DreamOneX/sleep-environment-monitor/docs/00-project/02-handoff.md

# Handoff

Last updated: 2026-05-26.

When future work changes task status, records a new acceptance result, or finds
a new risk, update [03-todo.md](03-todo.md) in the same documentation pass.

## Current State

Phase 24 is complete in the current working tree. Phase 24Z, the BLE+Wi-Fi
coexistence heap fix, live Wi-Fi/BLE ACK suppression validation, the
2026-05-26 LED/existing-peer auth validation evidence, the final LED3
post-boot/download-mode acceptance, and the Phase 24 phone/gateway
interoperability scope decision are implemented or documented.

Phase 24P added live BLE evidence for two storage-transfer checks and the
current LED status boundary:

- Post-ACK oldest-record advancement succeeded with `scan-ack-then-peek-next`:
  ACKed sequence `108009`, then observed next oldest sequence `108010`.
- Disconnect before `CompleteRecord` or `AckRecord` preserved the oldest record
  after a drain precondition: first and second metadata reads both reported
  sequence `109130`, payload length `199`.
- LED facts are corrected: LED1 is green power on the 3.3 V rail and is not
  MCU-controlled; LED2 is red active-low on IO0; LED3 is blue active-low on IO1.
- Firmware keeps LED2 as heartbeat with a short boot/reset fast-flash and uses
  LED3 as normal status plus time-bounded BLE status overlay.

Phase 24Q added a compile-validated BLE security and authorization-record
persistence path. Phase 24R then validated the first Windows saved-bond restore
path on hardware and added a runtime saved-auth clear gesture:

- `firmware/src/storage/ble_auth.rs` now models fixed-size BLE auth records
  with identity address, LTK, optional IRK, security level, bonded flag, record
  CRC, record-set checksum, version policy, load/store/clear helpers, and pure
  tests.
- `firmware/src/tasks/ble.rs` seeds TrouBLE security from TRNG, restores saved
  bond records before host build, proactively requests security only while the
  BOOT / IO9 pairing window is open, requires encrypted matching saved auth
  outside the BOOT / IO9 window, and stores a bond record on
  `PairingComplete`.
- `tools/ble-watch` now includes `scan-read-metadata-now`, Windows Custom
  ConfirmOnly pairing, Windows pairing-state logging, `no-pair` mode,
  `scan-unpair`, and `scan-watch-clear-gesture`.
- Runtime BOOT / IO9 handling keeps the 2 second authorization-window gesture
  and adds an 8 second saved-auth clear gesture that erases
  `0x003bf000..0x003c0000` and reopens the temporary window.
- Hardware validation confirmed Windows pairing, BLE auth-sector write after
  `PairingComplete`, reboot restore of one saved authorization record, and
  encrypted metadata access with `scan-read-metadata-now ... expect-success
  no-pair`.

Phase 24S separated plain Wi-Fi/IP-not-ready indication from explicit network
faults in the blue LED3 policy:

- `config::led::WIFI_UNREADY_STATUS_WINDOW_SECS` defaults to `0`, disabling
  the plain Wi-Fi-unready slow-blink hint.
- Explicit `ErrorFlags::WIFI`, `ErrorFlags::IP`, and
  `ErrorFlags::DISCOVERY` still slow-blink LED3 through
  `ErrorFlags::NETWORK_MASK`.
- `ErrorFlags::NETWORK_MASK` remains scoped to the Wi-Fi/IP/discovery REST
  upload path and does not include BLE advertising, BLE connection, or BLE
  authorization state.
- BLE LED wording is aligned to the implemented runtime states:
  pairing/authorization fast blink and advertising-or-connected slow blink.

Phase 24T hardware-validated the BLE auth metadata reset policy:

- The existing BLE auth metadata sector was backed up from
  `0x003bf000..0x003c0000` to `/tmp/ble-auth-before-phase24t.bin`.
- Only `0x003bf000..0x003c0000` was deliberately written or erased with
  `cargo espflash write-bin` and `cargo espflash erase-region`.
- Missing/erased metadata, bad header magic, empty current-version records,
  records-version mismatch, compatibility-checksum mismatch, and header
  checksum mismatch all auto-opened the temporary authorization window on boot.
- After the final reset window closed, `scan-read-metadata-now ... expect-reject
  no-pair` confirmed an unpaired central was rejected at protected metadata
  control write.
- This did not validate the runtime 8 second BOOT / IO9 clear gesture itself.

Phase 24U hardened the Windows central validation tool after stale WinRT/GATT
objects blocked more hardware validation:

- GATT service and characteristic lookup now retry Uncached lookup and then use
  Cached lookup as a Windows stale-cache recovery fallback.
- Status reads retry but still use only Uncached status values for runtime
  decisions.
- `scan-read-status` can recreate the Windows `BluetoothLEDevice` / GATT
  objects after repeated status-read failures.
- `scan-watch-clear-gesture` can reconnect after a transient status-read
  failure instead of immediately ending the delay-safe watch.
- `scan-unpair` cleared the Windows-side pairing/cache state during recovery.

Phase 24V hardware-validated the runtime saved-auth clear effect:

- After Phase 24T left the board with invalid auth metadata and Windows unpaired,
  a non-flashing `probe-rs reset --chip esp32c3` reopened the temporary
  authorization window and restored BOOT / IO9 diagnostics to
  `boot_button=Released pressed_ms=0`.
- `scan-read-metadata-now 30 sleep-env-esp32c3 expect-success auto-pair`
  rebuilt one Windows saved-bond auth record. This may write only the BLE auth
  metadata sector `0x003bf000..0x003c0000`.
- `scan-read-metadata-now 30 sleep-env-esp32c3 expect-success no-pair` then
  confirmed protected metadata access through the saved authorization record.
- `scan-watch-clear-gesture 30 sleep-env-esp32c3 180 8000` observed
  `CLEAR_GESTURE_PRESSED_AFTER_RELEASE`,
  `CLEAR_GESTURE_HOLD_THRESHOLD pressed_ms=8000`, and
  `CLEAR_GESTURE_WINDOW_REFRESHED remaining_ms=60000`.
- The watch did not produce final `CLEAR_GESTURE_RESULT success=True` because
  firmware status frames continued to report `boot_button=Pressed` after the
  operator released IO9. The operator did not hold IO9 for 40 seconds or
  longer; treat this as an IO9 release-diagnostics mismatch.
- `scan-read-metadata-now 30 sleep-env-esp32c3 expect-reject no-pair` reported
  `METADATA_NOW_RESULT success=True metadata_success=False rejected=True
  phase=control_write`, proving the previous saved authorization no longer
  grants protected metadata access.
- After a non-flashing `probe-rs reset --chip esp32c3`, `scan-unpair` reported
  `UNPAIR_RESULT status=Unpaired`, and a final status read decoded
  `pairing=Open boot_button=Released remaining_ms=39050 pressed_ms=0`.

Phase 24W improved `tools/ble-watch` release diagnostics for the next runtime
clear retest:

- `scan-watch-clear-gesture` still requires release before press,
  press-after-release, 8 second hold threshold, refreshed authorization window,
  and release after hold before returning success.
- The tool now prints `CLEAR_GESTURE_CLEAR_EFFECT_OBSERVED` after hold
  threshold plus refreshed-window evidence.
- If the watch ends after that clear-effect evidence but before final release
  observation, it prints `CLEAR_GESTURE_RELEASE_DIAGNOSTIC_MISSING` with event
  indexes, hold milliseconds, refreshed-window remaining milliseconds, and
  latest status fields.
- The new diagnostic output does not change firmware behavior and does not
  accept the BOOT / IO9 release item by itself.

Phase 24X added pure BLE auth-record upsert policy coverage and reused it from
the target persistence path:

- `storage::ble_auth::upsert_auth_record` updates an existing record by
  identity address or matching IRK, appends while capacity remains, replaces
  index `0` when full, clamps overlarge stored record counts, and reports
  `NoCapacity` for empty storage.
- `firmware/src/tasks/ble.rs` now calls that pure policy when persisting a
  `PairingComplete` bond record.
- This is compile and host-test coverage only. Real runtime auth-record
  replacement/update still needs hardware validation with another bond or an
  existing peer update.

Phase 24Y added firmware-side BOOT / IO9 transition logging for the next
release-diagnostics retest:

- The BLE pairing task logs the initial BOOT / IO9 runtime sample.
- It logs each sampled transition between `Pressed` and `Released`.
- Each log includes accumulated press milliseconds and pairing-window remaining
  milliseconds.
- This does not change pairing-window or saved-auth clear behavior and does not
  accept the release-diagnostics item without a new hardware run.

A 2026-05-25 hardware review corrected the BOOT / IO9 electrical assumptions:

- The board has no discrete IO9 pull-up resistor.
- ESP32-C3 boot/strap sampling provides a weak IO9 pull-up during boot, but
  runtime firmware must not assume that pull-up remains configured.
- The BOOT button pulls IO9 to GND and has an IO9-to-GND capacitor in parallel.
- BLE feature builds now configure GPIO9 as input-only with the MCU internal
  pull-up explicitly enabled at runtime.
- The IO9-to-GND capacitor and previous no-pull runtime configuration may
  explain the earlier `Pressed`-after-release status observation. Retest
  release diagnostics with the explicit runtime pull-up firmware before drawing
  conclusions about BLE status/tooling.

Phase 24Z retested BOOT / IO9 with the explicit runtime GPIO9 pull-up firmware:

- The BLE+Wi-Fi app image was flashed after declaring the app-image range as
  approximately `0x00010000..0x003bf000`.
- The runtime clear gesture deliberately erased the BLE auth metadata sector
  `0x003bf000..0x003c0000`.
- `scan-watch-clear-gesture 30 sleep-env-esp32c3 180 8000` observed release
  before press, press-after-release, `CLEAR_GESTURE_HOLD_THRESHOLD
  pressed_ms=8100`, refreshed authorization window `remaining_ms=59900`, final
  release after hold, and `CLEAR_GESTURE_RESULT success=True`.
- Firmware RTT logs matched the central output with
  `ble boot/io9 transition state=Pressed`, `ble auth records clear requested
  pressed_ms=8000`, `ble auth records cleared offset=0x003bf000 len=4096`, and
  `ble boot/io9 transition state=Released`.
- After the refreshed authorization window expired,
  `scan-read-metadata-now 30 sleep-env-esp32c3 expect-reject no-pair` reported
  `METADATA_NOW_RESULT success=True metadata_success=False rejected=True
  phase=control_write`.
- The BOOT / IO9 runtime clear/release diagnostic item is now hardware
  accepted for the explicit runtime pull-up firmware.
- The same BLE+Wi-Fi runtime reported `Wi-Fi controller initialization failed;
  network and uploader disabled` with ESP Wi-Fi init error `257`; this is now
  a remaining Wi-Fi/BLE runtime coexistence issue to resolve or explicitly
  accept before Phase 24 closes.

The follow-up BLE+Wi-Fi coexistence heap fix resolves the Phase 24Z Wi-Fi
controller initialization failure as a startup blocker:

- BLE+Wi-Fi feature builds now add a second internal heap region of 64 KiB in
  addition to the reclaimed heap. This follows the `esp-generate` Wi-Fi+BLE
  template pattern that notes coexistence needs more RAM.
- The Wi-Fi initialization failure log now preserves the concrete `WifiError`
  enum for future diagnosis.
- A hardware `cargo run --target riscv32imc-unknown-none-elf --features
  ble-upload,radio-coex` flashed the app image after declaring the app-image
  range as approximately `0x00010000..0x003bf000`.
- RTT logs showed `wifi connecting`, `wifi connected`, IPv4 configuration,
  BLE advertising, and BLE central connect/disconnect events. The previous
  `Wi-Fi controller initialization failed ... error=257` log did not appear.
- `ble-watch scan-read-status 30 sleep-env-esp32c3` succeeded and decoded
  `runtime=Connected network=IpReady upload=TimeFailed pending=32`, proving
  the BLE GATT status path and IP-ready Wi-Fi status were present in the same
  BLE+Wi-Fi runtime.
The subsequent live Wi-Fi/BLE ACK suppression run accepts the Phase 24
coexistence ACK-policy item for the observed hardware case:

- The formal server accepted repeated REST uploads from the board with HTTP
  `204`; firmware logs showed discovery, time sync, and `upload success`.
- `scan-transfer-record-now 30 sleep-env-esp32c3 ack 128 auto-pair` transferred
  sequence `136853` without waiting for a BOOT / IO9 authorization window.
- Initial and final BLE status snapshots decoded
  `runtime=Connected network=IpReady upload=Success pending=0`.
- The Windows central requested `AckRecord`, but firmware logged
  `ble storage ACK suppressed sequence=136853 network_state=IpReady
  upload_result=Success`.
- This proves the live BLE ACK path does not delete storage while Wi-Fi/IP is
  ready and REST upload is succeeding.

The 2026-05-26 hardware session accepted the existing Windows-central
auth-record update path and two LED3 BLE visual states:

- `scan-unpair-then-pair-metadata` opened the authorization window but timed
  out near the manual timing boundary. A following
  `scan-read-metadata-now 30 sleep-env-esp32c3 expect-success auto-pair`
  completed pairing and read protected metadata.
- Firmware RTT logs showed `ble auth record updated index=0` and
  `ble auth bond stored count=1 offset=0x003bf000 len=4096`, accepting the
  existing-peer runtime update path.
- While `scan-watch-status` held a BLE connection with `pairing=Closed`, the
  operator reported `LED3 慢闪`, accepting the advertising-or-connected slow
  blink for the exercised state.
- During a BOOT / IO9-triggered `pairing=Open` window, the operator reported
  `LED3 快闪`, accepting the pairing/authorization fast blink for the exercised
  state and the BOOT-triggered overlay case where the pairing window remains
  open longer than 10 seconds.
- That manual fast-blink hold also crossed the 8 second clear threshold again.
  Firmware logged `ble auth records clear requested pressed_ms=8000` and
  `ble auth records cleared offset=0x003bf000 len=4096`, so the BLE auth
  metadata sector was exercised during this session.
- A following hard reset restored the application BLE path. After clearing
  stale Windows-side pairing state with `scan-unpair`, `scan-read-status`
  decoded `runtime=Connected network=IpReady upload=TransportFailed
  pending=32` and `pairing=Closed boot_button=Released`.
- Read-only BOOT/download-mode probes were inconclusive: `cargo espflash
  board-info` attempts using `--before no-reset --after no-reset`, `--before
  usb-reset --after no-reset`, and `--before default-reset --after hard-reset`
  all failed with `Error while connecting to device`. Do not count that as
  download-mode preservation evidence. After the failed probes, BLE status
  reads still confirmed the application path can recover:
  `runtime=Connected network=IpReady upload=TransportFailed pending=32` and
  `pairing=Closed boot_button=Released`.

The final Phase 24 acceptance pass closed the remaining Phase 24 hardware and
scope items:

- `tools/ble-watch scan-watch-status` now reopens the Windows GATT status
  connection if a long status watch hits a recoverable stale WinRT/GATT object.
  The Windows .NET build passed with 0 warnings and 0 errors.
- After `probe-rs reset --chip esp32c3`, `scan-watch-status 30
  sleep-env-esp32c3 180` started a machine-side status trace and decoded
  `runtime=Connected network=IpReady`, `pairing=Open`, and
  `boot_button=Released` early in the post-boot window. The operator manually
  accepted the blue LED3 180 second post-boot BLE status window.
- BOOT / IO9 download-mode preservation during reset or power-on was accepted
  by operator-assisted validation. This validates that holding BOOT / IO9 at
  reset or power-on still selects ESP32-C3 download mode rather than runtime
  BLE pairing or BLE auth-record clearing.
- Phone/gateway interoperability beyond the Windows `ble-watch` central is
  `skipped / not planned` for Phase 24. This repository does not implement a
  mobile app or gateway in Phase 24; Windows `ble-watch` remains the accepted
  Phase 24 validation central. Future phone/gateway behavior should start from
  a separate app/gateway plan if that product direction is revived.
- A final `scan-read-status 30 sleep-env-esp32c3` confirmed the application BLE
  path recovered after the acceptance steps:
  `runtime=Connected network=IpReady upload=TimeFailed pending=32` and
  `pairing=Closed boot_button=Released`.

Firmware was flashed during Phase 24R hardware validation with the BLE+Wi-Fi
build using `probe-rs` through the ESP JTAG interface. Before flashing, the
declared ranges were:

Important flash ranges:

- App firmware region: approximately `0x00010000..0x003bf000`.
- BLE auth metadata sector: `0x003bf000..0x003c0000`. Phase 24R deliberately
  exercised a write to this sector through `PairingComplete` and restored one
  saved record after reboot. Phase 24T deliberately erased or overwrote this
  same sector to validate reset/invalid metadata auto-pair behavior. Phase 24V
  validated the runtime clear effect through hold-threshold/window-refresh
  evidence and rejected protected metadata access after the clear watch.
  Phase 24Z validated final BOOT / IO9 release-after-hold diagnostics and again
  cleared this sector through the runtime gesture. The 2026-05-26
  existing-peer update wrote this sector through bond storage, and the later
  LED3 fast-blink check erased it again through the runtime clear gesture.
- Measurement spool: `0x003c0000..0x00400000`. BLE ACK/drain validation may
  exercise normal spool writes/erases through `storage_task` in this range.
  During the long Phase 24R runtime, the storage task continued appending and
  dropping oldest records as the spool filled.

Before any future flash-write validation, state the exact range being
exercised.

## Implemented

- `tools/ble-watch` includes `scan-drain-then-disconnect-preserves-record`.
- `tools/ble-watch` retries Windows GATT service and characteristic lookup,
  retries Uncached status reads, recreates status connections for
  `scan-read-status`, reconnects the runtime clear-gesture watch after a
  transient status-read failure, and reconnects `scan-watch-status` after a
  recoverable stale WinRT/GATT status-read failure. It also distinguishes
  clear-effect evidence from missing final release observation in
  `scan-watch-clear-gesture`.
- `firmware/src/board.rs` maps MCU-controlled LEDs as `PIN_LED2 = 0` and
  `PIN_LED3 = 1`.
- `firmware/src/tasks/led.rs` fast-flashes red LED2 at boot/reset and then runs
  the heartbeat.
- `firmware/src/util/status.rs` exposes pure LED status mapping for the blue
  LED3 BLE overlay, including pairing fast blink, BLE runtime slow blink, and
  boot/trigger indication windows.
- `firmware/src/tasks/led.rs` uses
  `config::led::WIFI_UNREADY_STATUS_WINDOW_SECS` to decide whether plain
  Wi-Fi/IP-not-ready state should temporarily slow-blink LED3. The default `0`
  keeps that hint disabled, while explicit network error flags still slow-blink.
- `firmware/src/bin/main.rs` routes GPIO0 to the LED2 heartbeat task and GPIO1
  to the LED3 status task, and wires BLE runtime/pairing signals into LED3.
- `firmware/src/tasks/ble.rs` publishes BLE runtime and pairing status for the
  LED overlay, owns the BLE security compile path, and stores/loads BLE auth
  records through the reserved auth sector using the shared pure upsert policy.
  It also clears the saved auth sector on the 8 second runtime BOOT / IO9
  gesture and logs BOOT / IO9 initial/transition samples for release
  diagnostics. GPIO9 is configured input-only with the MCU internal pull-up
  explicitly enabled in BLE feature builds.
- `firmware/src/bin/main.rs` obtains a BLE security seed from TRNG before
  reusing ADC1 for the microphone path.
- `tools/ble-watch` includes `scan-transfer-record-now` for saved-bond or
  auto-pair transfer without waiting for the BOOT / IO9 authorization window.
- Documentation records Phase 24P storage-transfer evidence, Phase 24R
  saved-bond restore evidence, Phase 24S LED status/config boundary, Phase 24T
  auth metadata reset evidence, Phase 24U Windows GATT recovery tooling,
  Phase 24V runtime clear-effect evidence, Phase 24W clear-gesture diagnostic
  tooling, Phase 24X auth-record upsert policy coverage, Phase 24Y BOOT / IO9
  transition diagnostics, Phase 24Z runtime IO9 pull-up retest evidence, the
  BLE+Wi-Fi coexistence heap startup fix, live Wi-Fi/BLE ACK suppression
  evidence, existing-peer auth update evidence, current LED mapping, final
  LED3 visual acceptance, BOOT download-mode acceptance, and the Phase 24
  phone/gateway `skipped / not planned` scope decision.

The hardware-validated BLE authorization paths are now the temporary BOOT / IO9
window, the Windows saved-bond restore path, the auth metadata reset policy,
the Phase 24Z runtime clear/release path, and the existing Windows-central
auth-record update path. The latest board state has firmware auth metadata
cleared or missing after the 2026-05-26 LED3 fast-blink hold crossed the clear
threshold. Windows Settings may show the custom GATT peripheral as paired but
not connected when `ble-watch` is not holding a GATT session; that passive
Settings label is not a Phase 24 acceptance signal. If Windows still reports
paired while firmware rejects protected access after an auth reset or clear,
use `scan-unpair` before re-pairing. A distinct second-central append or
full-capacity auth replacement run remains useful future coverage, but the
existing-peer update item has hardware evidence.

Current board/test starting point:

- No new firmware image was flashed during the 2026-05-26 LED/existing-peer
  auth session.
- No `probe-rs`, `ble-watch`, `espflash`, or local server process should be
  assumed to still be running from that session.
- After the final acceptance pass, the application BLE path was reachable. The
  latest useful status evidence decoded
  `runtime=Connected network=IpReady upload=TimeFailed pending=32` and
  `pairing=Closed boot_button=Released`.
- The firmware auth metadata is likely cleared or missing because the last
  BOOT / IO9 fast-blink observation crossed the 8 second runtime clear
  threshold. Protected metadata, transfer, or saved-bond tests should expect to
  re-pair first, and stale Windows pairing should be removed with `scan-unpair`
  if firmware rejects access.
- The older `cargo espflash board-info` attempts are failed/inconclusive
  historical evidence, not the accepted download-mode validation. The final
  operator-assisted BOOT / IO9 reset or power-on check accepted download-mode
  preservation for Phase 24.

Manual hardware tests that need operator timing, such as BOOT / IO9 presses,
must first notify the operator through PowerShell
`New-BurntToastNotification`. Do not assume human cooperation is available
until the operator replies in chat that the notification was received and they
are ready. The same rule is recorded in local `environment.md`, which is
ignored by `.gitignore`.

## Subagents

Requested subagents completed or reported during this handoff:

- Documentation/fact check: no high-severity current fact conflicts were found.
  The important follow-up was to keep old "paired central" wording precise and
  keep old LED2 status wording marked as historical where relevant.
- Architecture file-tree/config update: directly updated
  `docs/10-firmware/00-architecture.md` with directory-first file tree and
  `config.rs` ownership details.
- Wi-Fi config check: default `FZU` open network remains a bring-up default and
  should not be treated as a deployment credential model; future work should
  avoid committing real passwords, mark WPA/mixed modes as legacy, and consider
  test/build-time validation for the default credential triple.
- Duplicate-code check: Phase 24 should avoid broad refactors; Phase 25 should
  keep `docs/10-firmware/05-ble.md` as the BLE ACK/security rule authority,
  keep LED overlay rules centralized, and split protocol/helper duplication
  only after behavior is frozen.
- `cfg(target_arch = "riscv32")` check: most cfgs are valid embedded/host-test
  boundaries; the real boundary debt is the large `tasks/ble.rs` module, which
  should be split in Phase 25 after behavior is frozen.
- Phase 25 refactor plan: split `tools/ble-watch`, `tasks/upload.rs`, and
  `tasks/ble.rs` by equivalent moves only. Freeze BLE UUIDs, status/metadata /
  control frame bytes, Wi-Fi HTTP 2xx ACK semantics, BLE ACK policy, flash
  ranges, and payload JSON shape.

## Verification

Phase 24T firmware and documentation verification passed:

```bash
cargo fmt
cargo test --lib
cargo build --target riscv32imc-unknown-none-elf
cargo build --target riscv32imc-unknown-none-elf --features ble-upload,radio-coex
cargo clippy --all-targets
cargo clippy --target riscv32imc-unknown-none-elf
cargo clippy --target riscv32imc-unknown-none-elf --features ble-upload,radio-coex
git diff --check
```

Observed result:

- `cargo test --lib`: `185 passed; 0 failed`.
- Normal ESP32-C3 target build: passed.
- BLE+Wi-Fi coexistence ESP32-C3 target build: passed.
- Host clippy, normal target clippy, and BLE+coex target clippy: passed.
- `git diff --check`: passed.

Milestone commit message:

```text
test: validate BLE auth metadata reset policy
```

Phase 24U tool verification:

```bash
'/mnt/c/Program Files/dotnet/dotnet.exe' build "$(wslpath -w tools/ble-watch/ble-watch.csproj)"
'/mnt/c/Program Files/dotnet/dotnet.exe' "$(wslpath -w tools/ble-watch/bin/Debug/net10.0-windows10.0.19041.0/ble-watch.dll)" scan-unpair 30 sleep-env-esp32c3
'/mnt/c/Program Files/dotnet/dotnet.exe' "$(wslpath -w tools/ble-watch/bin/Debug/net10.0-windows10.0.19041.0/ble-watch.dll)" scan-read-status 30 sleep-env-esp32c3
git diff --check
```

Observed result:

- The Windows .NET build passed with 0 warnings and 0 errors.
- `scan-unpair` reported `UNPAIR_RESULT status=Unpaired`.
- A following `scan-read-status` succeeded after stale GATT recovery and
  decoded `runtime=Connected network=Disconnected upload=Failed pending=32
  error_flags=0x00000000 pairing=Closed boot_button=Released remaining_ms=0
  pressed_ms=0`.
- No firmware image was flashed and no firmware flash sector was deliberately
  written or erased.

Milestone commit message:

```text
test: harden BLE watch GATT recovery
```

Phase 24V hardware verification:

```bash
probe-rs reset --chip esp32c3
'/mnt/c/Program Files/dotnet/dotnet.exe' "$(wslpath -w tools/ble-watch/bin/Debug/net10.0-windows10.0.19041.0/ble-watch.dll)" scan-read-status 30 sleep-env-esp32c3
'/mnt/c/Program Files/dotnet/dotnet.exe' "$(wslpath -w tools/ble-watch/bin/Debug/net10.0-windows10.0.19041.0/ble-watch.dll)" scan-read-metadata-now 30 sleep-env-esp32c3 expect-success auto-pair
'/mnt/c/Program Files/dotnet/dotnet.exe' "$(wslpath -w tools/ble-watch/bin/Debug/net10.0-windows10.0.19041.0/ble-watch.dll)" scan-read-metadata-now 30 sleep-env-esp32c3 expect-success no-pair
'/mnt/c/Program Files/dotnet/dotnet.exe' "$(wslpath -w tools/ble-watch/bin/Debug/net10.0-windows10.0.19041.0/ble-watch.dll)" scan-watch-clear-gesture 30 sleep-env-esp32c3 180 8000
'/mnt/c/Program Files/dotnet/dotnet.exe' "$(wslpath -w tools/ble-watch/bin/Debug/net10.0-windows10.0.19041.0/ble-watch.dll)" scan-read-metadata-now 30 sleep-env-esp32c3 expect-reject no-pair
probe-rs reset --chip esp32c3
'/mnt/c/Program Files/dotnet/dotnet.exe' "$(wslpath -w tools/ble-watch/bin/Debug/net10.0-windows10.0.19041.0/ble-watch.dll)" scan-unpair 30 sleep-env-esp32c3
'/mnt/c/Program Files/dotnet/dotnet.exe' "$(wslpath -w tools/ble-watch/bin/Debug/net10.0-windows10.0.19041.0/ble-watch.dll)" scan-read-status 30 sleep-env-esp32c3
git diff --check
```

Observed result:

- Saved auth was rebuilt and confirmed with `expect-success no-pair`.
- The clear watch observed an 8 second hold threshold and a refreshed
  authorization window.
- Protected metadata access was rejected after the clear watch, proving the
  previous saved authorization no longer granted access.
- Firmware status kept reporting `Pressed` after operator release; the operator
  did not hold IO9 for 40 seconds or longer.
- No firmware image was flashed; the runtime clear path may erase only
  `0x003bf000..0x003c0000`.

Milestone commit message:

```text
test: validate BLE runtime auth clear effect
```

Phase 24W tool verification:

```bash
'/mnt/c/Program Files/dotnet/dotnet.exe' build "$(wslpath -w tools/ble-watch/ble-watch.csproj)"
git diff --check
```

Observed result:

- The Windows .NET build passed with 0 warnings and 0 errors.
- No firmware image was flashed and no firmware flash sector was deliberately
  written or erased.
- No hardware validation was run for this tooling milestone.

Milestone commit message:

```text
test: improve BLE clear gesture diagnostics
```

Phase 24X pure logic and target compile verification:

```bash
cargo fmt
cargo test --lib
cargo build --target riscv32imc-unknown-none-elf
cargo clippy --all-targets
cargo clippy --target riscv32imc-unknown-none-elf
cargo build --target riscv32imc-unknown-none-elf --features ble-upload,radio-coex
cargo clippy --target riscv32imc-unknown-none-elf --features ble-upload,radio-coex
git diff --check
```

Observed result:

- `cargo test --lib`: `191 passed; 0 failed`.
- BLE auth-record upsert pure tests covered same identity-address update, same
  IRK update, append, oldest replacement at index `0`, count clamping, and
  zero-capacity handling.
- Default non-BLE target build and default target clippy passed.
- `cargo clippy --all-targets` passed.
- BLE+Wi-Fi target build and clippy passed with `ble-upload,radio-coex`.
- `git diff --check` passed.
- No firmware image was flashed and no firmware flash sector was deliberately
  written or erased.

Milestone commit message:

```text
test: cover BLE auth record upsert policy
```

Phase 24Y diagnostic compile verification:

```bash
cargo fmt
cargo test --lib
cargo build --target riscv32imc-unknown-none-elf
cargo clippy --all-targets
cargo clippy --target riscv32imc-unknown-none-elf
cargo build --target riscv32imc-unknown-none-elf --features ble-upload,radio-coex
cargo clippy --target riscv32imc-unknown-none-elf --features ble-upload,radio-coex
```

Observed result:

- `cargo test --lib`: `191 passed; 0 failed`.
- Default non-BLE target build and default target clippy passed.
- `cargo clippy --all-targets` passed.
- BLE+Wi-Fi target build and clippy passed with `ble-upload,radio-coex`.
- No firmware image was flashed and no firmware flash sector was deliberately
  written or erased.

Milestone commit message:

```text
test: add BOOT IO9 release diagnostics
```

## Remaining Phase 24 Work

- None for Phase 24.
- Phone/gateway interoperability beyond the Windows `ble-watch` central is
  `skipped / not planned` for Phase 24 because no mobile app or gateway is
  implemented in this repository.
- Keep distinct second-central append or full-capacity auth replacement
  validation as future coverage beyond the now-accepted existing-peer update.

## Phase 25 Notes

Phase 25 is complete in the current working tree. It was a behavior-preserving
split of Phase 24 maintenance modules:

- `tools/ble-watch/Program.cs` now uses `tools/ble-watch/src/` helpers for BLE
  profile UUIDs, scanner behavior, protocol/status decoding, protected GATT
  reads, models, output formatting, and WinRT pairing helpers. CLI commands and
  output labels are preserved.
- `firmware/src/tasks/upload/` separates endpoint/types, JSON, HTTP,
  discovery/time parsing, time selection, and target runtime uploader logic.
- `firmware/src/tasks/ble/` separates profile, protocol, pairing, status,
  transfer, target BLE auth, storage bridge, GATT, and runtime code while
  preserving `tasks::ble::*`.
- `firmware/src/storage/spool/`, `firmware/src/storage/ble_auth/`, and
  `firmware/src/tasks/storage/` now separate their pure policy/codec pieces
  from flash-backed or target runtime code while preserving public paths.

Phase 25 did not change BLE UUIDs, frame layouts, ACK conditions, Wi-Fi retry /
discovery / time-sync behavior, flash ranges, BOOT / IO9 behavior, LED3 overlay
rules, or measurement payload JSON shape. Future optional split candidate:
`firmware/src/drivers/flash.rs`.
