DreamOneX/sleep-environment-monitor/hardware/exports/sleep-monitor-pcb.png

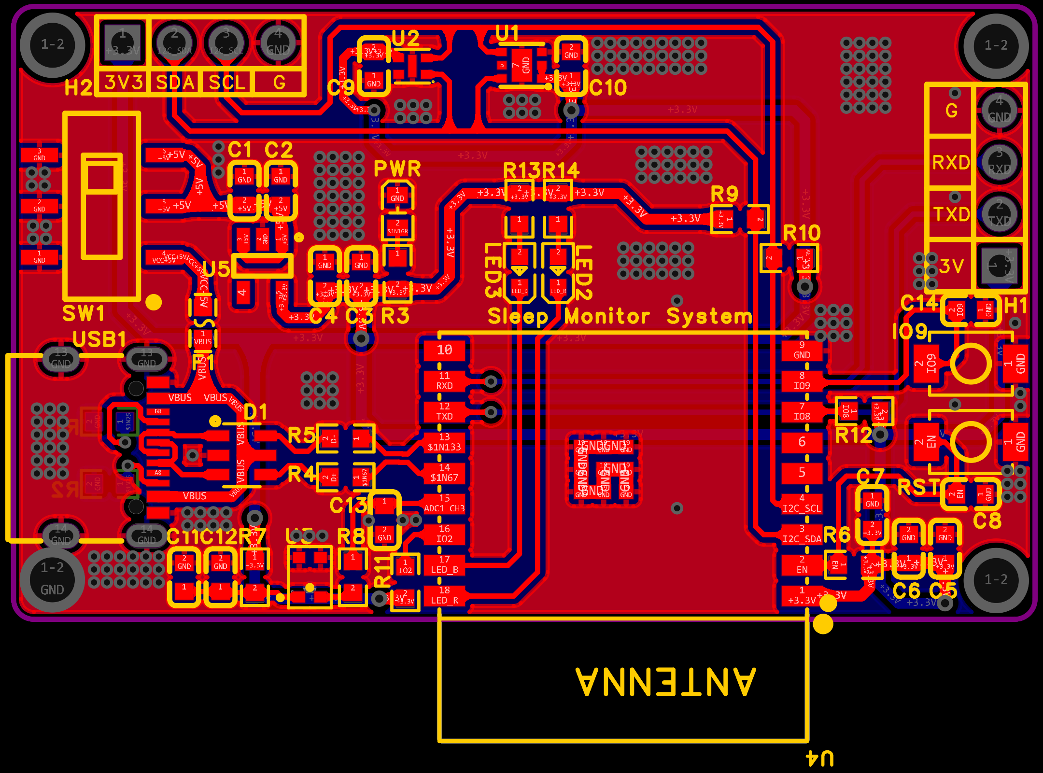
hardware/exports/sleep-monitor-pcb.png
