DreamOneX/sleep-environment-monitor/hardware/fabrication/assembly/sleep-monitor-bom.xlsx

No. | Quantity | Comment | Designator | Footprint | Value | Manufacturer Part | Manufacturer | Supplier Part | Supplier
1 | 3 | 10uF | C1,C3,C5 | C0603 | 10uF | CL10A106KP8NNNC | SAMSUNG(三星) | C19702 | LCSC
2 | 8 | 100nF | C2,C4,C6,C8,C9,C10,C12,C14 | C0603 | 100nF | CL10B104KB8NNNC | SAMSUNG(三星) | C1591 | LCSC
3 | 2 | 1uF | C7,C11 | C0603 | 1uF | CL10A105KB8NNNC | SAMSUNG(三星) | C15849 | LCSC
4 | 1 | 10nF | C13 | C0603 | 10nF | 0603B103K500NT | FH(风华) | C57112 | LCSC
5 | 1 | USBLC6-2SC6 | D1 | SOT-23-6_L2.9-W1.6-P0.95-LS2.8-BL |  | USBLC6-2SC6 | ST(意法半导体) | C7519 | LCSC
6 | 1 | SMD0603-075 | F1 | F0603 |  | SMD0603-075 | 台湾陆海 | C70053 | LCSC
7 | 2 | PZ254V-11-04P | H1,H2 | HDR-TH_4P-P2.54-V-M |  | PZ254V-11-04P | XFCN(兴飞) | C492403 | LCSC
8 | 1 | NCD0603G1 | LED1 | LED0603-RD_1 |  | NCD0603G1 | 国星光电 | C84267 | LCSC
9 | 1 | NCD0603R5 | LED2 | LED0603-RD |  | NCD0603R5 | 国星光电 | C193902 | LCSC
10 | 1 | NCD0603B1 | LED3 | LED0603-RD |  | NCD0603B1 | 国星光电 | C84266 | LCSC
11 | 2 | 5.1kΩ | R1,R2 | R0603 | 5.1kΩ | 0603WAF5101T5E | UNI-ROYAL(厚声) | C23186 | LCSC
12 | 5 | 4.7kΩ | R3,R9,R10,R13,R14 | R0603 | 4.7kΩ | 0603WAF4701T5E | UNI-ROYAL(厚声) | C23162 | LCSC
13 | 2 | 0Ω | R4,R5 | R0603 | 0Ω | 0603WAF0000T5E | UNI-ROYAL(厚声) | C21189 | LCSC
14 | 3 | 10kΩ | R6,R11,R12 | R0603 | 10kΩ | 0603WAF1002T5E | UNI-ROYAL(厚声) | C25804 | LCSC
15 | 1 | 22Ω | R7 | R0603 | 22Ω | FRC0603F22R0TS | FOJAN(富捷) | C2930077 | LCSC
16 | 1 | 1kΩ | R8 | R0603 | 1kΩ | 0603WAF1001T5E | UNI-ROYAL(厚声) | C21190 | LCSC
17 | 1 | SS-3235S-L1 | SW1 | SW-SMD_SS-3235S-LX |  | SS-3235S-L1 | XKB Connection(中国星坤) | C500055 | LCSC
18 | 2 | TS-1088-AR02016 | SW2,SW3 | SW-SMD_L3.9-W3.0-P4.45 |  | TS-1088-AR02016 | XUNPU(讯普) | C720477 | LCSC
19 | 1 | OPT3001IDNPRQ1 | U1 | WSON-6_L2.0-W2.0-P0.65-BL-EP |  | OPT3001IDNPRQ1 | TI(德州仪器) | C2861428 | LCSC
20 | 1 | SHT40-AD1B-R3 | U2 | DFN-4_L1.5-W1.5-P0.8-TL-EP |  | SHT40-AD1B-R3 | Sensirion(瑞士盛思锐) | C2848306 | LCSC
21 | 1 | MSM381ACP003 | U3 | MIC-SMD_4P-L2.8-W1.9-TR_MSM381ACP003 |  | MSM381ACP003 | MEMS(敏芯微) | C51928212 | LCSC
22 | 1 | 2.4GHz | U4 | BULETM-SMD_ESPRESSIF_ESP32-C3-WROOM-02-N4-4MB | 2.4GHz | ESP32-C3-WROOM-02-N4 | ESPRESSIF(乐鑫) | C2934560 | LCSC
23 | 1 | AP2112K-3.3TRG1 | U5 | SOT-25-5_L2.9-W1.6-P0.95-LS2.8-BL |  | AP2112K-3.3TRG1 | DIODES(美台) | C51118 | LCSC
24 | 1 | TYPE-C 16PIN 2MD(073) | USB1 | USB-C-SMD_TYPE-C-16PIN-2MD-073 |  | TYPE-C 16PIN 2MD(073) | SHOU HAN(首韩) | C2765186 | LCSC
