DreamOneX/sleep-environment-monitor/hardware/exports/sleep-monitor-schematic.pdf

板子 | Sleep Monitor | 图页 | P1 EP

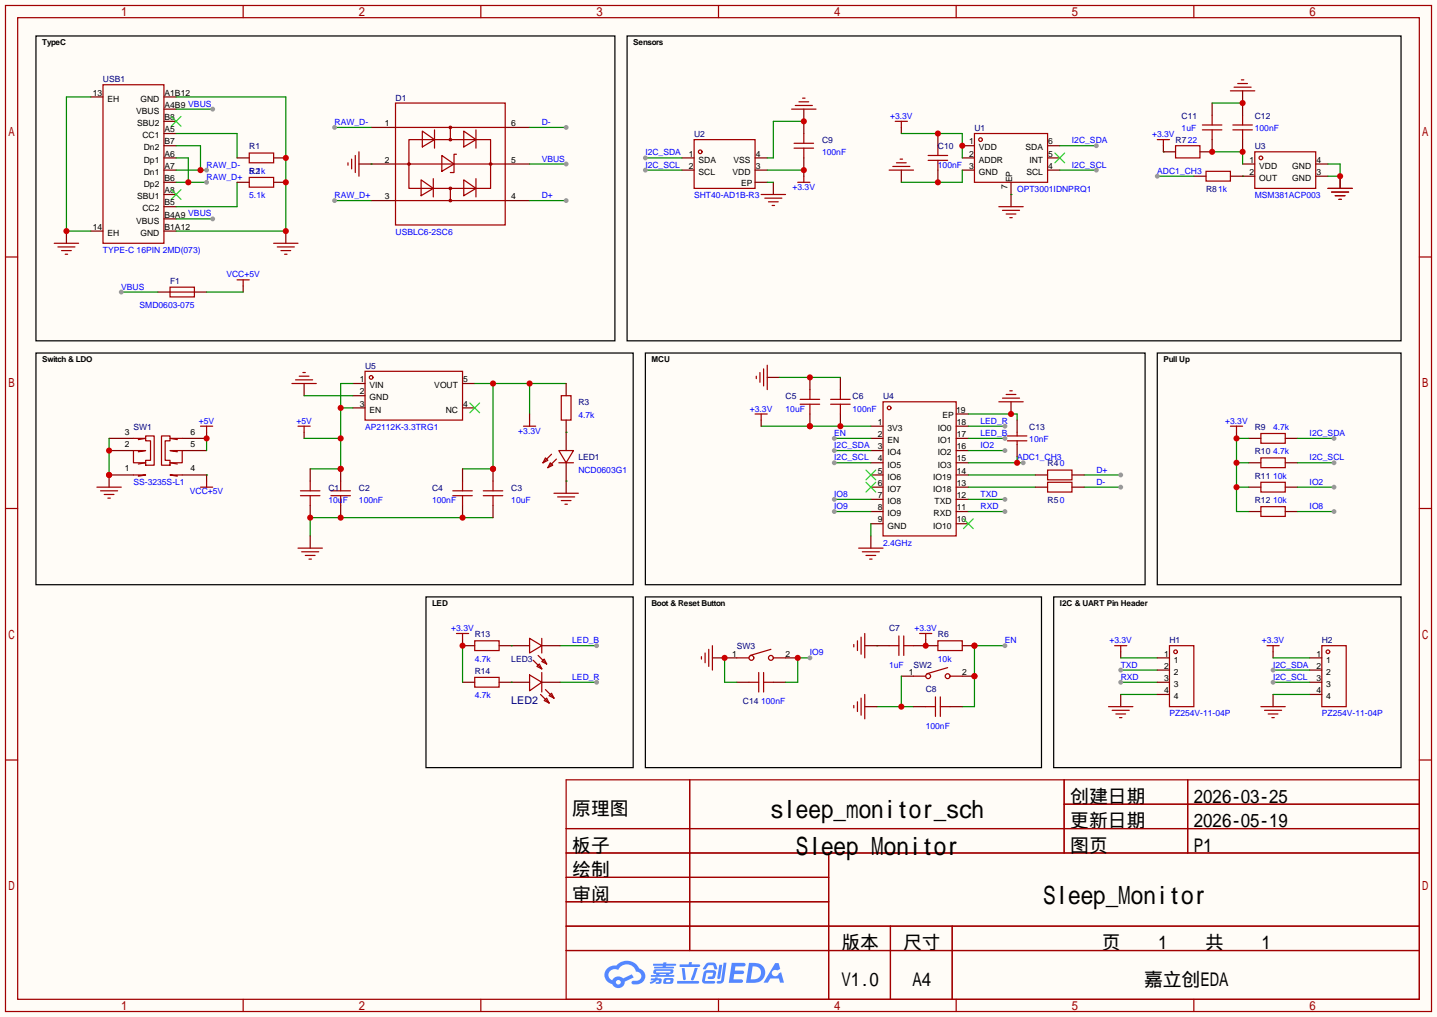
[picture p7: page 1]

原理图 | sleep_monitor_sch | 创建日期 | 2026-03-25

更新日期 | 2026-05-19

绘制 | Sleep_Monitor
审阅

V1.0 | A4 | 嘉立创EDA
