DreamOneX/sleep-environment-monitor/(list of files, drawings)

Other design files:
hardware/easyeda/sleep-monitor.epro
