DreamOneX/sleep-environment-monitor/firmware/src/types.rs

use core::ops::{BitOr, BitOrAssign};

#[derive(Clone, Copy, Debug, Default, Eq, PartialEq)]
#[cfg_attr(target_arch = "riscv32", derive(defmt::Format))]
pub struct ErrorFlags(u32);

impl ErrorFlags {
    pub const NONE: Self = Self(0);
    pub const SHT40: Self = Self(1 << 0);
    pub const OPT3001: Self = Self(1 << 1);
    pub const MIC: Self = Self(1 << 2);
    pub const WIFI: Self = Self(1 << 3);
    pub const UPLOAD: Self = Self(1 << 4);
    pub const STORAGE: Self = Self(1 << 5);
    pub const IP: Self = Self(1 << 6);
    pub const DISCOVERY: Self = Self(1 << 7);
    pub const TIME: Self = Self(1 << 8);
    pub const TRANSPORT: Self = Self(1 << 9);
    pub const HTTP: Self = Self(1 << 10);

    pub const SENSOR_MASK: Self = Self(Self::SHT40.0 | Self::OPT3001.0 | Self::MIC.0);
    pub const NETWORK_MASK: Self = Self(Self::WIFI.0 | Self::IP.0 | Self::DISCOVERY.0);
    pub const UPLOAD_MASK: Self = Self(Self::UPLOAD.0 | Self::TRANSPORT.0 | Self::HTTP.0);

    pub const fn from_bits(bits: u32) -> Self {
        Self(bits)
    }

    pub const fn bits(self) -> u32 {
        self.0
    }

    pub const fn is_empty(self) -> bool {
        self.0 == 0
    }

    pub fn insert(&mut self, flags: Self) {
        self.0 |= flags.0;
    }

    pub const fn contains(self, flags: Self) -> bool {
        (self.0 & flags.0) == flags.0
    }

    pub const fn intersects(self, flags: Self) -> bool {
        (self.0 & flags.0) != 0
    }
}

impl BitOr for ErrorFlags {
    type Output = Self;

    fn bitor(self, rhs: Self) -> Self::Output {
        Self(self.0 | rhs.0)
    }
}

impl BitOrAssign for ErrorFlags {
    fn bitor_assign(&mut self, rhs: Self) {
        self.insert(rhs);
    }
}

#[derive(Clone, Copy, Debug, PartialEq)]
pub struct EnvSample {
    pub uptime_ms: u64,
    pub temperature_c: Option<f32>,
    pub humidity_percent: Option<f32>,
    pub lux: Option<f32>,
    pub error_flags: ErrorFlags,
}

impl Default for EnvSample {
    fn default() -> Self {
        Self {
            uptime_ms: 0,
            temperature_c: None,
            humidity_percent: None,
            lux: None,
            error_flags: ErrorFlags::NONE,
        }
    }
}

#[derive(Clone, Copy, Debug, PartialEq)]
pub struct MicSample {
    pub uptime_ms: u64,
    pub mean: f32,
    pub rms: f32,
    pub peak: f32,
    pub db_rel: f32,
    pub clip_count: u32,
    pub error_flags: ErrorFlags,
}

impl Default for MicSample {
    fn default() -> Self {
        Self {
            uptime_ms: 0,
            mean: 0.0,
            rms: 0.0,
            peak: 0.0,
            db_rel: 0.0,
            clip_count: 0,
            error_flags: ErrorFlags::NONE,
        }
    }
}

#[derive(Clone, Copy, Debug, PartialEq)]
pub struct Measurement {
    pub uptime_ms: u64,
    pub temperature_c: Option<f32>,
    pub humidity_percent: Option<f32>,
    pub lux: Option<f32>,
    pub mic_mean: f32,
    pub mic_rms: f32,
    pub mic_peak: f32,
    pub mic_db_rel: f32,
    pub mic_clip_count: u32,
    pub error_flags: ErrorFlags,
}

impl Default for Measurement {
    fn default() -> Self {
        Self {
            uptime_ms: 0,
            temperature_c: None,
            humidity_percent: None,
            lux: None,
            mic_mean: 0.0,
            mic_rms: 0.0,
            mic_peak: 0.0,
            mic_db_rel: 0.0,
            mic_clip_count: 0,
            error_flags: ErrorFlags::NONE,
        }
    }
}

#[derive(Clone, Copy, Debug, Default, Eq, PartialEq)]
#[cfg_attr(target_arch = "riscv32", derive(defmt::Format))]
pub enum NetworkState {
    #[default]
    Disconnected,
    Connecting,
    Connected,
    IpReady,
}

#[derive(Clone, Copy, Debug, Default, Eq, PartialEq)]
#[cfg_attr(target_arch = "riscv32", derive(defmt::Format))]
pub enum UploadResult {
    #[default]
    Idle,
    Success,
    Failed,
    DiscoveryFailed,
    TimeFailed,
    TransportFailed,
    HttpFailed,
}

#[derive(Clone, Copy, Debug, Default, Eq, PartialEq)]
#[cfg_attr(target_arch = "riscv32", derive(defmt::Format))]
pub struct NetworkUploadStatus {
    pub network_state: NetworkState,
    pub upload_result: UploadResult,
}

impl NetworkUploadStatus {
    pub const fn new(network_state: NetworkState, upload_result: UploadResult) -> Self {
        Self {
            network_state,
            upload_result,
        }
    }

    pub const fn with_network_state(self, network_state: NetworkState) -> Self {
        Self {
            network_state,
            ..self
        }
    }

    pub const fn with_upload_result(self, upload_result: UploadResult) -> Self {
        Self {
            upload_result,
            ..self
        }
    }
}

#[derive(Clone, Copy, Debug, Default, Eq, PartialEq)]
#[cfg_attr(target_arch = "riscv32", derive(defmt::Format))]
pub struct FirmwareStatusSnapshot {
    pub pending_record_count: u16,
    pub error_flags: ErrorFlags,
}

impl FirmwareStatusSnapshot {
    pub const fn new(pending_record_count: u16, error_flags: ErrorFlags) -> Self {
        Self {
            pending_record_count,
            error_flags,
        }
    }

    pub const fn with_pending_record_count(self, pending_record_count: u16) -> Self {
        Self {
            pending_record_count,
            ..self
        }
    }

    pub const fn with_error_flags(self, error_flags: ErrorFlags) -> Self {
        Self {
            error_flags,
            ..self
        }
    }
}

#[derive(Clone, Copy, Debug, Default, Eq, PartialEq)]
#[cfg_attr(target_arch = "riscv32", derive(defmt::Format))]
pub enum TimeStatus {
    #[default]
    Unknown,
    UptimeOnly,
    WallClockSynced,
}

impl TimeStatus {
    pub const fn as_json_str(self) -> &'static str {
        match self {
            Self::Unknown => "unknown",
            Self::UptimeOnly => "uptime_only",
            Self::WallClockSynced => "wall_clock_synced",
        }
    }
}

#[cfg(test)]
mod tests {
    use super::*;

    #[test]
    fn error_flags_insert_adds_bits() {
        let mut flags = ErrorFlags::NONE;

        flags.insert(ErrorFlags::SHT40);
        flags.insert(ErrorFlags::UPLOAD);

        assert_eq!(
            flags.bits(),
            ErrorFlags::SHT40.bits() | ErrorFlags::UPLOAD.bits()
        );
    }

    #[test]
    fn error_flags_contains_checks_all_requested_bits() {
        let mut flags = ErrorFlags::SHT40;
        flags.insert(ErrorFlags::UPLOAD);

        assert!(flags.contains(ErrorFlags::SHT40));
        assert!(flags.contains(ErrorFlags::SHT40 | ErrorFlags::UPLOAD));
        assert!(!flags.contains(ErrorFlags::OPT3001));
    }

    #[test]
    fn storage_error_has_distinct_bit() {
        assert_eq!(ErrorFlags::STORAGE.bits(), 1 << 5);
        assert!(!ErrorFlags::SENSOR_MASK.contains(ErrorFlags::STORAGE));
    }

    #[test]
    fn network_and_upload_masks_cover_detailed_failures() {
        assert!(ErrorFlags::NETWORK_MASK.contains(ErrorFlags::WIFI));
        assert!(ErrorFlags::NETWORK_MASK.contains(ErrorFlags::IP));
        assert!(ErrorFlags::NETWORK_MASK.contains(ErrorFlags::DISCOVERY));
        assert!(ErrorFlags::UPLOAD_MASK.contains(ErrorFlags::UPLOAD));
        assert!(ErrorFlags::UPLOAD_MASK.contains(ErrorFlags::TRANSPORT));
        assert!(ErrorFlags::UPLOAD_MASK.contains(ErrorFlags::HTTP));
    }

    #[test]
    fn time_status_has_stable_json_names() {
        assert_eq!(TimeStatus::Unknown.as_json_str(), "unknown");
        assert_eq!(TimeStatus::UptimeOnly.as_json_str(), "uptime_only");
        assert_eq!(
            TimeStatus::WallClockSynced.as_json_str(),
            "wall_clock_synced"
        );
    }

    #[test]
    fn network_upload_status_updates_fields_independently() {
        let status = NetworkUploadStatus::default()
            .with_network_state(NetworkState::IpReady)
            .with_upload_result(UploadResult::Success);

        assert_eq!(
            status,
            NetworkUploadStatus::new(NetworkState::IpReady, UploadResult::Success)
        );
    }

    #[test]
    fn default_shared_samples_are_empty() {
        let env = EnvSample::default();
        let mic = MicSample::default();
        let measurement = Measurement::default();

        assert_eq!(env.uptime_ms, 0);
        assert_eq!(env.temperature_c, None);
        assert_eq!(env.humidity_percent, None);
        assert_eq!(env.lux, None);
        assert!(env.error_flags.is_empty());

        assert_eq!(mic.uptime_ms, 0);
        assert_eq!(mic.mean, 0.0);
        assert_eq!(mic.rms, 0.0);
        assert_eq!(mic.peak, 0.0);
        assert_eq!(mic.db_rel, 0.0);
        assert_eq!(mic.clip_count, 0);
        assert!(mic.error_flags.is_empty());

        assert_eq!(measurement.uptime_ms, 0);
        assert_eq!(measurement.temperature_c, None);
        assert_eq!(measurement.humidity_percent, None);
        assert_eq!(measurement.lux, None);
        assert_eq!(measurement.mic_mean, 0.0);
        assert_eq!(measurement.mic_rms, 0.0);
        assert_eq!(measurement.mic_peak, 0.0);
        assert_eq!(measurement.mic_db_rel, 0.0);
        assert_eq!(measurement.mic_clip_count, 0);
        assert!(measurement.error_flags.is_empty());
    }
}
