DreamOneX/sleep-environment-monitor/(commit log)

2026-05-19 test: add firmware core logic foundation
    Implement the hardware-independent foundation from the development plan phases 1-8.
    - scaffold board constants, shared types, and module tree
    - add SHT40 CRC/conversion parsing, OPT3001 lux conversion, and microphone ADC statistics
    - add drop-oldest upload queue, LED status mapping, aggregation, CSV payload encoding, and Wi-Fi reconnect state machine
    - make host unit tests work while preserving explicit ESP32-C3 target builds
    Verified with cargo test --lib and cargo build --target riscv32imc-unknown-none-elf.
2026-05-19 feat: bring up minimal LED heartbeat firmware
    Add the first hardware bring-up milestone for the ESP32-C3 board.
    - keep firmware startup limited to clocks, GPIO, Embassy runtime, and LED1 heartbeat
    - move active-low LED heartbeat into tasks::led
    - document milestone scope, manual checks, and verification commands in walkthrough.md
    Verified with cargo build, cargo test --lib, and cargo build --target riscv32imc-unknown-none-elf.
2026-05-19 feat: add I2C sensor bring-up task
    Bring up SHT40 and OPT3001 over the board I2C bus.
    - initialize I2C0 on GPIO4/GPIO5 and spawn the sensor task
    - add embedded-hal based hardware read wrappers for SHT40 and OPT3001
    - log periodic environment samples for hardware validation
    - update walkthrough with software checks, udev issue, and successful RTT sample logs
    Verified with cargo build, cargo test --lib, cargo build --target riscv32imc-unknown-none-elf, and cargo run --target riscv32imc-unknown-none-elf.
    [main.rs, opt3001.rs, sensor.rs, sht40.rs]
2026-05-19 feat: add microphone ADC sampling task
    Initialize ESP32-C3 ADC1 on GPIO3/ADC1_CH3 with 11 dB attenuation for the analog MEMS microphone.
    Add a riscv32-only Embassy microphone task that samples 1000 ADC values at 1 ms spacing, reuses the hardware-independent microphone statistics logic, and logs MicSample fields over defmt RTT.
    Spawn the microphone task alongside LED heartbeat and I2C sensor sampling, and document the milestone walkthrough including target builds, successful USB/JTAG flashing, baseline RTT readings, and the remaining manual sound-response check.
2026-05-19 feat: aggregate sensor and microphone measurements
    Wire the hardware sensor and microphone tasks into latest-value Embassy signals so each producer can publish samples without depending on Wi-Fi or upload code.
    Add a riscv32 aggregator task that waits for both sample streams, merges the latest EnvSample and MicSample into a Measurement, and logs a CSV payload using the existing encoder.
    Document the local aggregation milestone with host tests, target build, clippy, successful USB/JTAG flashing, and RTT logs showing continuous complete Measurement records with error_flags=0.
    [aggregator.rs, main.rs, mic.rs, mod.rs, sensor.rs]
2026-05-19 feat: add Wi-Fi connection manager
    Initialize the ESP32-C3 Wi-Fi controller after the RTOS scheduler starts and hand it to a dedicated hardware wifi_task.
    Connect to the open FZU station network, publish NetworkState through a task signal, and reuse the existing retry backoff policy for connection failures and disconnects.
    Document the milestone with host tests, target build, clippy, successful USB/JTAG flashing, RTT logs for connection, real disconnect backoff, automatic reconnect, and continued Measurement CSV output during network churn.
    [main.rs, mod.rs, wifi.rs]
2026-05-20 feat: add measurement upload task with offline queue
    Wire the ESP32-C3 station interface into embassy-net, add a network runner task, and enqueue aggregated Measurement records into a shared drop-oldest queue.
    Implement an uploader task that waits for IPv4 configuration, posts CSV measurements over HTTP, preserves queued data on failures, and removes records only after a 2xx response.
    Add host-side tests for HTTP request construction, response classification, queue overflow, and upload-success dequeue behavior. Document Milestone 7 hardware validation in walkthrough.md, including the observed ConnectReset caused by the external receiver not being reachable on 10.133.56.218:8080.
    [aggregator.rs, main.rs, mod.rs, net.rs]
2026-05-20 docs: record upload hardware validation success
    Capture the follow-up Phase 14 hardware run after inbound TCP/8080 was allowed on the Windows host. The walkthrough now distinguishes the earlier ConnectReset firewall failure from the successful end-to-end POST validation, including RTT upload-success lines and receiver CSV samples.
2026-05-20 fix: harden runtime error handling and status reporting
    Add the Phase 15 runtime-hardening milestone. LED2 now runs a status task fed by measurement error flags, network state, and upload results; upload failures are folded into status flags so the board has a visible failure state. Startup task creation and peripheral setup now log recoverable failures and publish fallback status/sample signals instead of panicking where the firmware can keep running. Microphone ADC reads use bounded retries, normal RTT output is throttled, and the walkthrough records the short ESP32-C3 hardware validation plus the remaining long-soak/visual LED checks.
    [aggregator.rs, led.rs, main.rs, mic.rs, mod.rs, sensor.rs]
2026-05-20 docs: document LED2 status patterns
    Add the explicit LED2 priority table to the architecture documentation, including sensor, upload, Wi-Fi, and normal-state meanings plus active-low blink timing. Update the Phase 15 walkthrough entry so the runtime-hardening milestone records the status LED documentation alongside the implementation.
2026-05-20 docs: plan persistent SPI flash measurement spool
    Update the architecture for a two-level backlog that keeps a RAM hot queue backed by an internal SPI flash persistent spool on the ESP32-C3 module. Document flash safety boundaries, the planned flash adapter, storage spool, storage task, record format, FIFO upload semantics, HTTP-2xx acknowledgement, reset recovery, corrupt-record handling, and drop-oldest behavior. Extend the development plan with Phase 16 through Phase 20 plus the new spool and flash-model unit test checklist, and record the documentation milestone in walkthrough.md.
2026-05-20 test: add persistent spool record logic
    Implement the Phase 16 hardware-independent persistent spool foundation. The new storage module defines the flash record header, CSV payload record encoding and decoding, CRC32 validation, FIFO append/peek/acknowledge behavior, sequence tracking, drop-oldest capacity handling, and recovery scanning for erased tails, partial tails, and bad-magic resynchronization. Add host unit coverage and record the milestone in walkthrough.md; no hardware flash writes are performed in this phase.
2026-05-20 test: model persistent measurement flash spool
    Add a host-side flash model that enforces erased bytes, clear-only writes, sector-aligned erases, and out-of-range access failures.
    Layer FlashBackedSpool over the model with data records, ack records, reboot recovery, compaction, drop-oldest behavior, and monotonic sequence preservation after ack/compaction.
    Document Milestone 11 in walkthrough.md with verification commands, 89 passing host tests, and the explicit hardware boundary: no real ESP32-C3 flash writes yet.
    [mod.rs]
2026-05-20 feat: define safe flash spool region
    Reserve the final 256 KiB of the ESP32-C3-WROOM-02-N4 4 MiB flash for measurement spooling and document the protected system and app ranges.
    Add host-testable flash layout validation for zero-sized regions, sector alignment, out-of-bounds ranges, and protected-region overlap before any real flash writes are enabled.
    Record Milestone 12 in walkthrough.md; this milestone intentionally does not flash firmware or erase/write real internal SPI flash.
2026-05-20 feat: bring up internal flash spool region
    Add an ESP32-C3 ROM-backed flash adapter for the reserved measurement spool region and gate the destructive boot-time smoke path behind the flash-smoke feature.
    Validate real internal SPI flash by erasing, reading, writing, reading back, and cleanup-erasing only 0x003c0000..0x003c1000, then reflash default firmware so normal boots do not run the smoke path.
    Keep host tests hardware-free, fix target-side clippy warnings, and record Milestone 13 in walkthrough.md with the exact hardware validation logs and remaining retention scope.
    [flash.rs, led.rs, main.rs]
2026-05-20 feat: persist measurement backlog in internal flash
    Add a storage task model over FlashBackedSpool that recovers pending CSV payloads, appends new measurements, serves oldest pending payloads, and acknowledges exactly one record only after uploader HTTP success.
    Wire aggregator and uploader through StorageCommand/StorageResponse, remove direct RAM queue ownership, report storage failures through ErrorFlags::STORAGE, and document the implemented Phase 19 protocol and remaining hardware validation.
    [aggregator.rs, main.rs, mod.rs, types.rs]
2026-05-20 docs: record persistent spool hardware recovery validation
    Document the Phase 19 hardware check using the normal storage task path over 0x003c_0000..0x0040_0000, including receiver-offline persistence, reset while offline, recovered pending_len=32, and recovered records uploading before new post-reset records.
    Refresh SESSION_HANDOFF.md so the next session starts from the current committed Phase 19 state and clearly preserves the remaining Phase 20 soak, metrics, LED, Wi-Fi disconnect, and power-interruption validation work.
2026-05-20 fix: harden persistent spool recovery metrics
    Add recovery and drop-count metrics for the flash-backed measurement spool so Phase 20 can observe pending, recovered, corrupt, dropped-oldest, and last-error state from RTT/status output.
    Thread StorageMetrics through StorageBacklog recovery, append, ACK, and error paths, and replace the previous pending-length log trigger with event-throttled storage metrics suitable for longer runs while still logging the first dropped-oldest transition.
    Extend host tests for recovery reports, corrupt tails, full-spool drops, ACK metric updates, and storage error metrics. Record the limited hardware validation that exercised the normal storage_task flash ran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
2026-05-20 docs: record receiver-offline reset recovery metrics
    Document the Phase 20 hardware run that used elevated probe-rs attach to capture receiver-offline backlog growth, software reset recovery, and receiver-return upload draining with storage metrics enabled.
    Record the normal firmware flash range used for persistent measurement writes, 0x003c_0000..0x0040_0000, and note that flash-smoke was not enabled during this validation.
    Keep SESSION_HANDOFF.md local-only; this commit updates only the tracked walkthrough milestone.
2026-05-22 feat: add BLE runtime ACK wiring
2026-05-24 docs: add project todo ledger
2026-05-24 fix: make Wi-Fi-unready LED status configurable
    [config.rs, led.rs]
2026-05-24 docs: add hardware design files
    [board-outline.GKO, bottom-copper.GBL, bottom-paste.GBP, bottom-silkscreen.GBO, bottom-solder-mask.GBS, non-plated-through-holes.DRL, plated-through-holes.DRL, plated-vias.DRL]
2026-05-24 fix: enable runtime BOOT IO9 pull-up
    [main.rs]
2026-05-24 fix: add BLE Wi-Fi coexistence heap
    [config.rs, main.rs]
2026-05-25 docs: describe current server behavior
